joshy409/Pressure_Sensitive_Carpet/README.md

# Pressure_Sensitive_Carpet
Pressure sensitive carpet using Arduino Uno microprocessor

Project for BEE 484 Sensors course
